Mocolax/martha/pcb/martha_circuits/martha_circuits.kicad_pcb

## KiCad design pcb/martha_circuits/martha_circuits.kicad_pcb (2026-08-06)

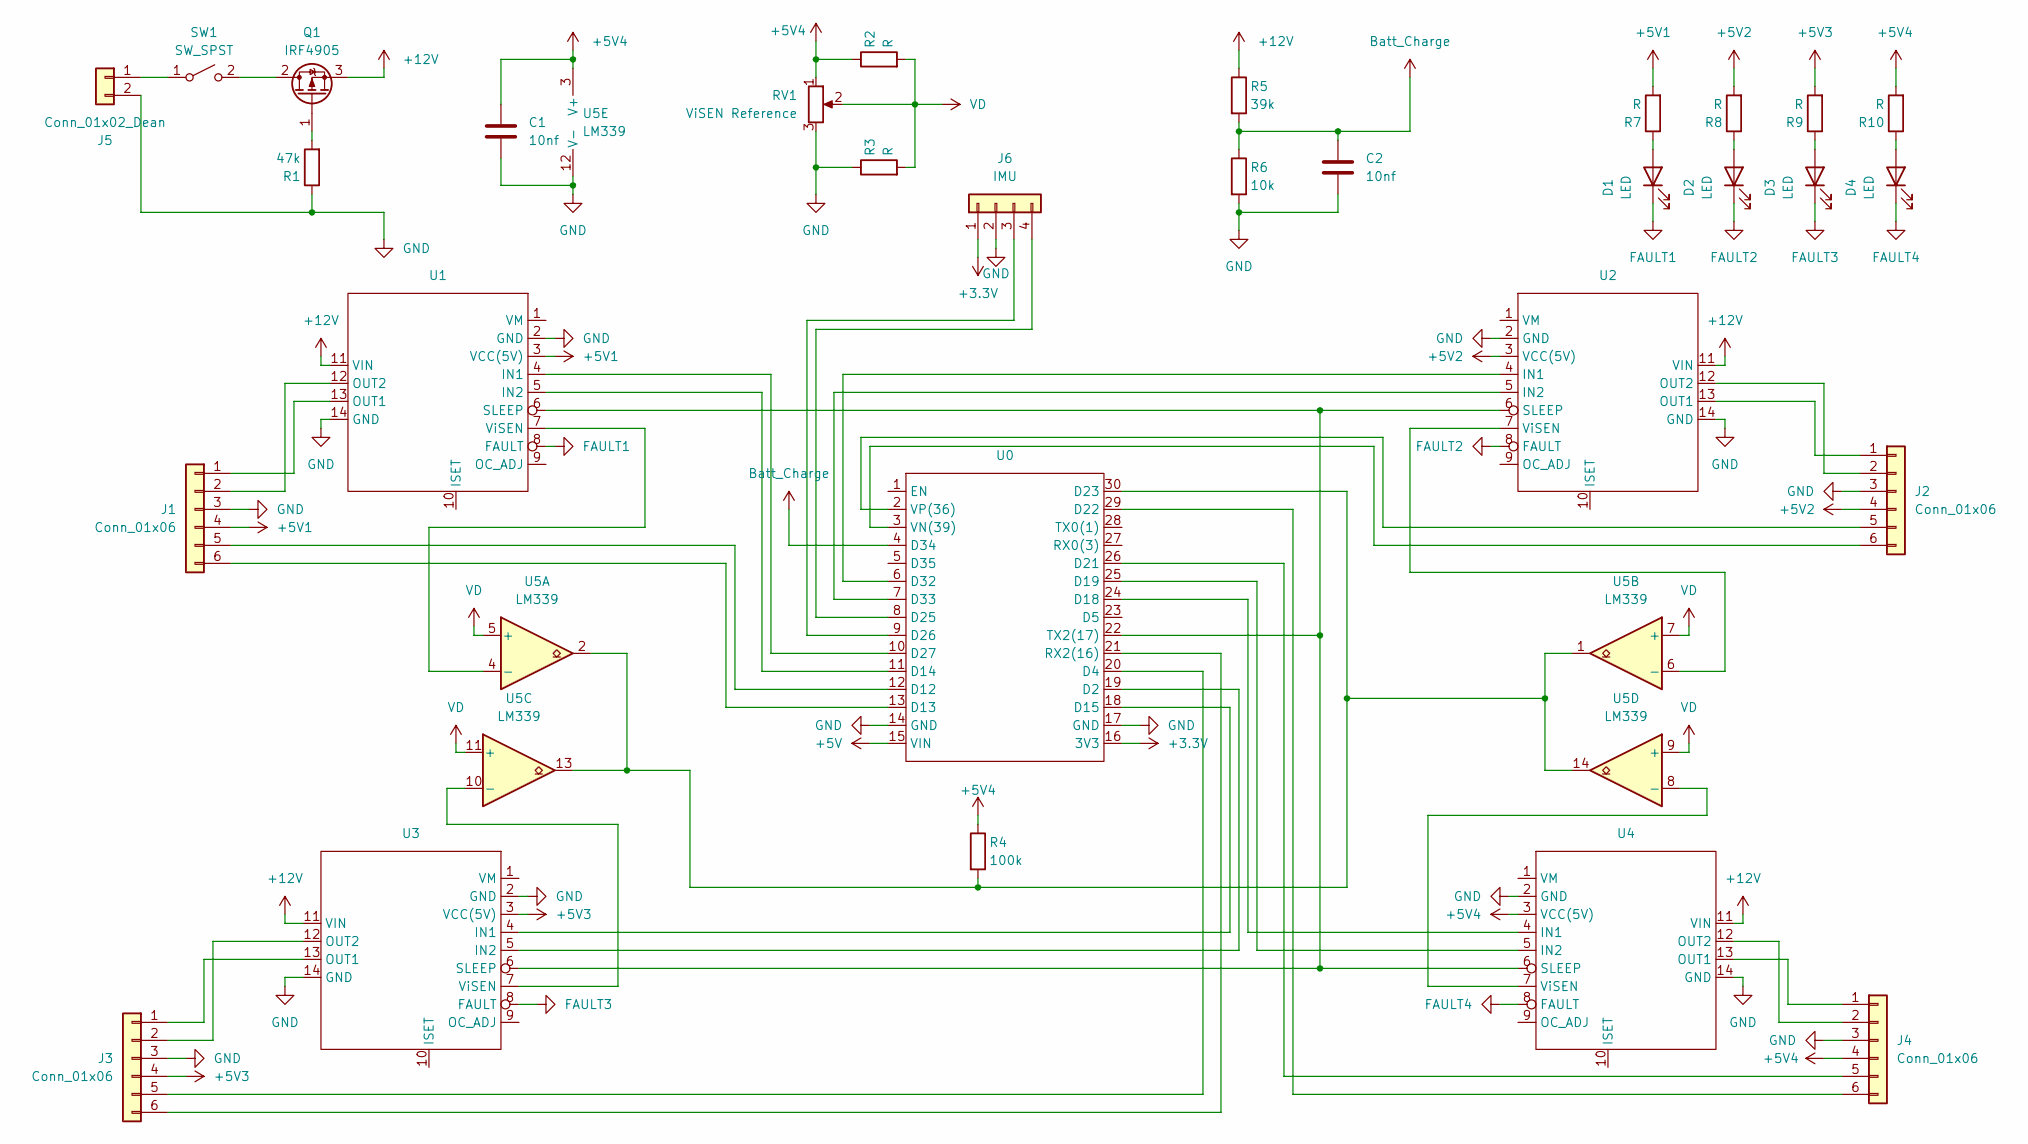
[picture p1: schematic martha_circuits.kicad_sch, Martha Circuit]

Parts:
C1, C2: 10nf; C_Disc_D5.0mm_W2.5mm_P2.50mm
D1, D2, D3, D4: LED; LED_D5.0mm
J1, J2, J3, J4: Conn_01x06; PinHeader_1x06_P2.54mm_Horizontal_Mirrored
J5: Conn_01x02_Dean; DEANS
J6: IMU; PinHeader_1x08_P2.54mm_Vertical
Q1: IRF4905; TO-220-3_Vertical
R1: 47k; R_Axial_DIN0207_L6.3mm_D2.5mm_P7.62mm_Horizontal
R2, R3, R7, R8, R9, R10: R; R_Axial_DIN0207_L6.3mm_D2.5mm_P7.62mm_Horizontal
R4: 100k; R_Axial_DIN0207_L6.3mm_D2.5mm_P7.62mm_Horizontal
R5: 39k; R_Axial_DIN0207_L6.3mm_D2.5mm_P7.62mm_Horizontal
R6: 10k; R_Axial_DIN0207_L6.3mm_D2.5mm_P7.62mm_Horizontal
RV1: ViSEN Reference; Potentiometer_Bourns_3296W_Vertical
SW1: SW_SPST; SolderWire-0.75sqmm_1x02_P4.8mm_D1.25mm_OD2.3mm
U0: ESP32_DevKit_30Pin
U1, U2, U3, U4: MPQ6612A
U5: LM339; DIP-14_W7.62mm

Connections:
+3.3V: J6.1, U0.16 (3V3)
+5V: U0.15 (VIN)
+5V1: J1.4, R7.2, U1.3 (VCC(5V))
+5V2: J2.4, R8.2, U2.3 (VCC(5V))
+5V3: J3.4, R9.2, U3.3 (VCC(5V))
+5V4: C1.1, J4.4, R2.1, R4.1, R10.2, RV1.1, U4.3 (VCC(5V)), U5.3 (V+)
+12V: Q1.3 (S), R5.1, U1.11 (VIN), U2.11 (VIN), U3.11 (VIN), U4.11 (VIN)
Batt_Charge: C2.1, R5.2, R6.1, U0.4 (D34)
FAULT1: D1.1 (K), U1.8 (FAULT)
FAULT2: D2.1 (K), U2.8 (FAULT)
FAULT3: D3.1 (K), U3.8 (FAULT)
FAULT4: D4.1 (K), U4.8 (FAULT)
GND: C1.2, C2.2, J1.3, J2.3, J3.3, J4.3, J5.2, J6.2, R1.1, R3.1, R6.2, RV1.3, U0.14 (GND), U0.17 (GND), U1.2 (GND), U1.14 (GND), U2.2 (GND), U2.14 (GND), U3.2 (GND), U3.14 (GND), U4.2 (GND), U4.14 (GND), U5.12 (V-)
unnamed: D1.2 (A), R7.1
unnamed: D2.2 (A), R8.1
unnamed: D3.2 (A), R9.1
unnamed: D4.2 (A), R10.1
unnamed: J1.1, U1.13 (OUT1)
unnamed: J1.2, U1.12 (OUT2)
unnamed: J1.5, U0.12 (D12)
unnamed: J1.6, U0.13 (D13)
unnamed: J2.1, U2.13 (OUT1)
unnamed: J2.2, U2.12 (OUT2)
unnamed: J2.5, U0.2 (VP(36))
unnamed: J2.6, U0.3 (VN(39))
unnamed: J3.1, U3.13 (OUT1)
unnamed: J3.2, U3.12 (OUT2)
unnamed: J3.5, U0.20 (D4)
unnamed: J3.6, U0.21 (RX2(16))
unnamed: J4.1, U4.13 (OUT1)
unnamed: J4.2, U4.12 (OUT2)
unnamed: J4.5, U0.26 (D21)
unnamed: J4.6, U0.29 (D22)
unnamed: J5.1, SW1.1 (A)
unnamed: J6.3, U0.9 (D26)
unnamed: J6.4, U0.8 (D25)
unnamed: Q1.2 (D), SW1.2 (B)
unnamed: Q1.1 (G), R1.2
unnamed: U0.19 (D2), U3.5 (IN2)
unnamed: U0.11 (D14), U1.5 (IN2)
unnamed: U0.18 (D15), U3.4 (IN1)
unnamed: U0.24 (D18), U4.4 (IN1)
unnamed: U0.25 (D19), U4.5 (IN2)
unnamed: R4.2, U0.30 (D23), U5.1, U5.2, U5.13, U5.14
unnamed: U0.10 (D27), U1.4 (IN1)
unnamed: U0.6 (D32), U2.4 (IN1)
unnamed: U0.7 (D33), U2.5 (IN2)
unnamed: U0.22 (TX2(17)), U1.6 (SLEEP), U2.6 (SLEEP), U3.6 (SLEEP), U4.6 (SLEEP)
unnamed: U1.7 (ViSEN), U5.4 (-)
unnamed: U2.7 (ViSEN), U5.6 (-)
unnamed: U3.7 (ViSEN), U5.10 (-)
unnamed: U4.7 (ViSEN), U5.8 (-)
VD: R2.2, R3.2, RV1.2, U5.5 (+), U5.7 (+), U5.9 (+), U5.11 (+)

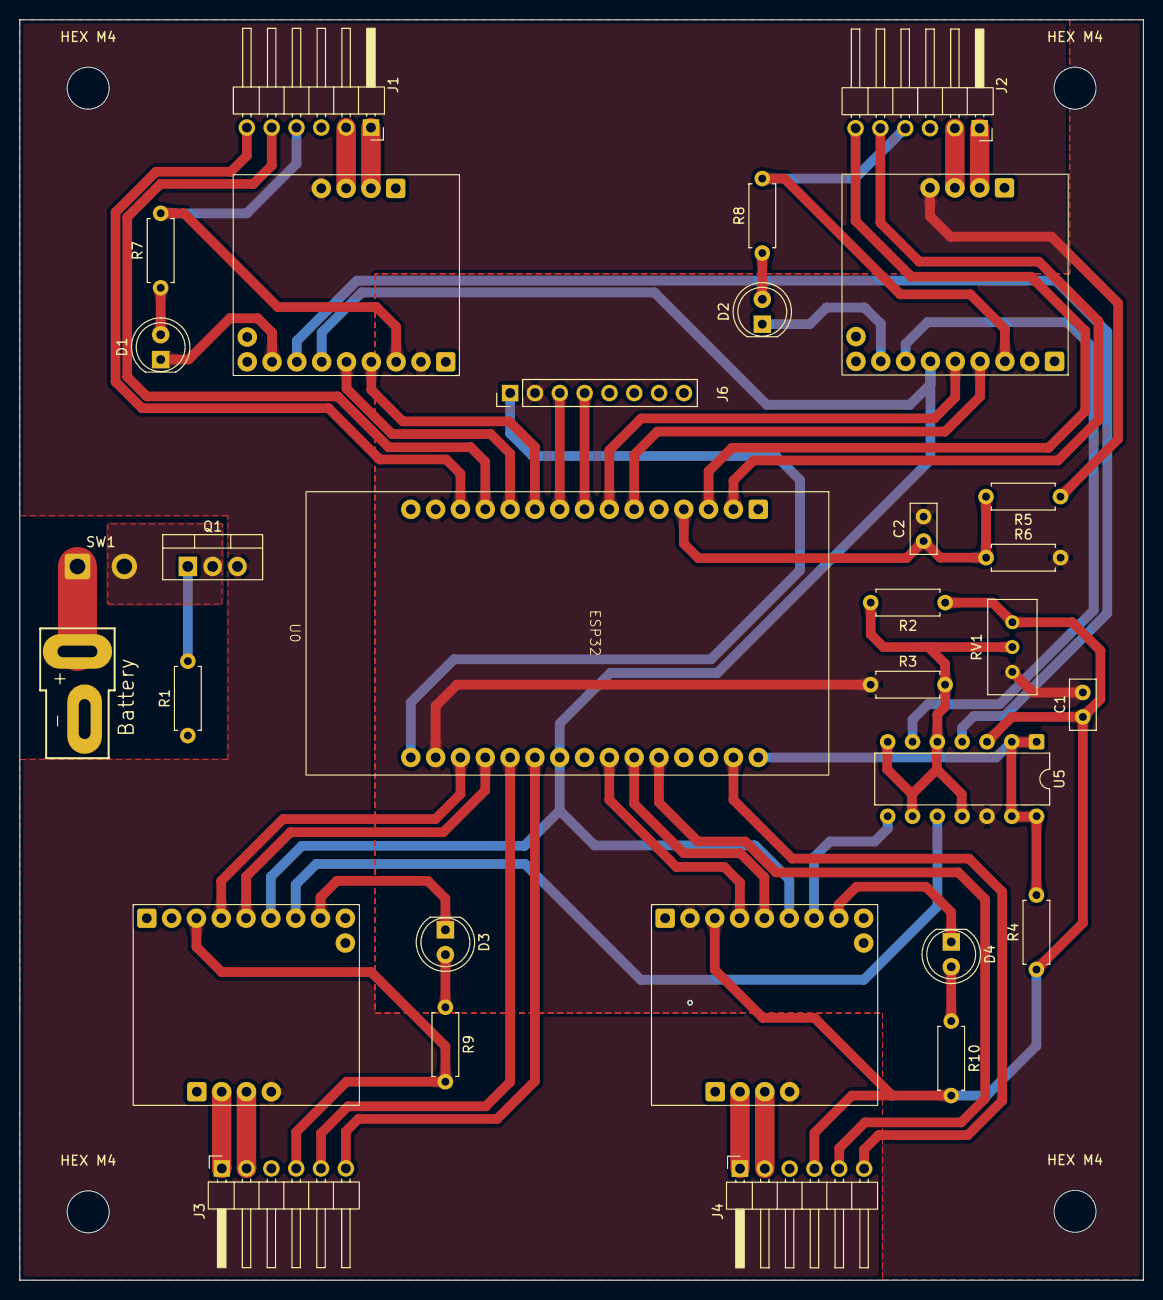
[picture p2: board martha_circuits.kicad_pcb from above]

Board: 2 copper layers, 115.0 x 129.0 mm, 35 parts (0 on the bottom side), 52 nets.

Other parts of the board:
HEX M4, HEX M4#2, HEX M4#3, HEX M4#4: MountingHole_4.3mm_M4
