Mocolax/martha/config/ekf_hardware.yaml

ekf_filter_node:
  ros__parameters:
    use_sim_time: false
    frequency: 50.0
    sensor_timeout: 0.2
    two_d_mode: true
    transform_time_offset: 0.0
    transform_timeout: 0.0
    print_diagnostics: true
    debug: false

    map_frame: map
    odom_frame: odom
    base_link_frame: base_link
    world_frame: odom

    publish_tf: true
    publish_acceleration: false

    # La pose integrada del ESP32 queda disponible en /wheel/odometry, pero
    # el filtro integra las velocidades para evitar contar dos veces lo mismo.
    odom0: /wheel/odometry
    odom0_config: [
      false, false, false,
      false, false, false,
      true,  true,  false,
      false, false, true,
      false, false, false
    ]
    odom0_queue_size: 10
    odom0_differential: false
    odom0_relative: false

    # El yaw absoluto del MPU depende de integrar el giroscopio y puede derivar.
    # Se fusiona gyro Z junto con el giro estimado por los encoders.
    imu0: /imu/data
    imu0_config: [
      false, false, false,
      false, false, false,
      false, false, false,
      false, false, true,
      false, false, false
    ]
    imu0_queue_size: 20
    imu0_differential: false
    imu0_relative: false
    imu0_remove_gravitational_acceleration: false
