Mocolax/martha/(commit log)

2025-09-30 Recibir velocidad desde placa
2025-10-07 Factorizacion ni la bestia, y primer intento odometria
2025-10-21 No se xd
    [martha.urdf]
2026-07-02 Codebase cleanup: removed files for real robot movement now we can simulate in gazebo, Rviz and use SLAM toolbox to map the environment Initial files for PPO reinforcement learning algorithm to train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
    [controllers.yaml, learning.urdf, learning.xacro, martha.urdf]
2026-07-03 Cleanup after Merge
    [martha.urdf]
2026-07-19 - IMU Implemetation for Simulations - Sensor fusion with EKF filter - Initial Schematic design for main PCB - Initial implemetation of ESP32 control algorithm (PI Control, IMU and Encoder Readings)
    [learning.xacro, martha_circuits.kicad_pcb, martha_circuits.kicad_sch]
2026-07-22 Component rearrangement, and use of power symbols to reduce wiring in schematic. Add Deans connector footprint
    [martha_circuits.kicad_pcb, martha_circuits.kicad_sch]
2026-07-24 Schematics and PCB development
    [martha_circuits.kicad_pcb, martha_circuits.kicad_sch]
2026-07-27 Some corrections from Miti
    [martha_circuits.kicad_pcb, martha_circuits.kicad_sch]
2026-08-06 - First PPO implementation (Read the Code) - PCB finished (Must ask teacher for corrections)
    [ekf_hardware.yaml, hardware_bridge.yaml, learning.xacro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]
2026-08-13 A lot of things XD
    [learning.urdf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]
